yashmangrole/Kruger-Robot/images/Krugger.png

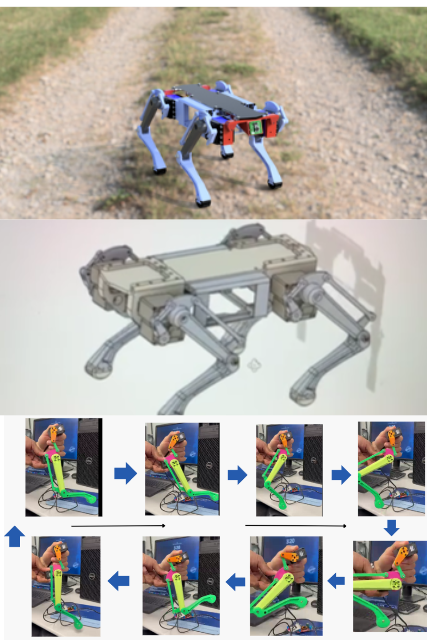
images/Krugger.png
