yashmangrole/Kruger-Robot/images/Kruger1.png

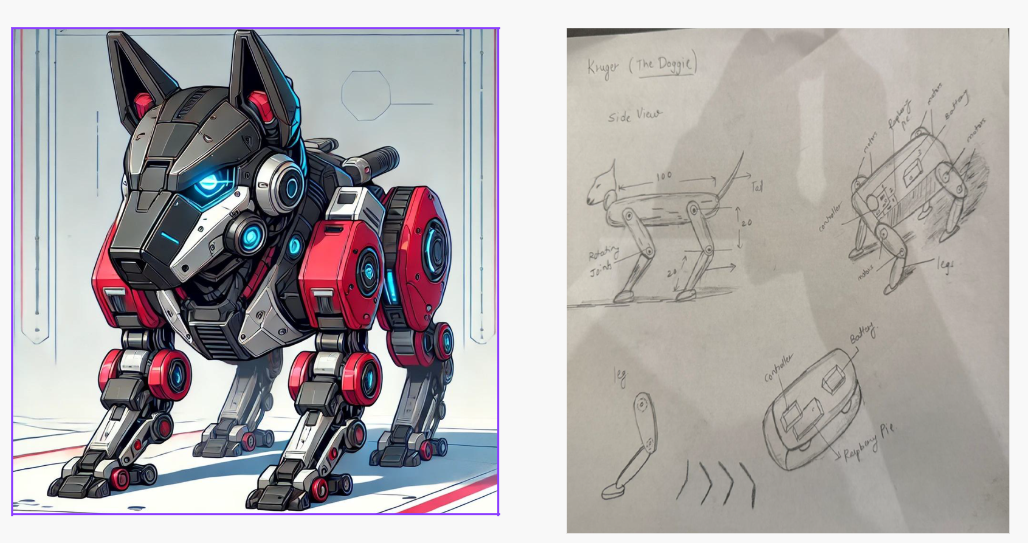
images/Kruger1.png
