yashmangrole/Kruger-Robot/docs/Assignment4_LegMotion.pdf

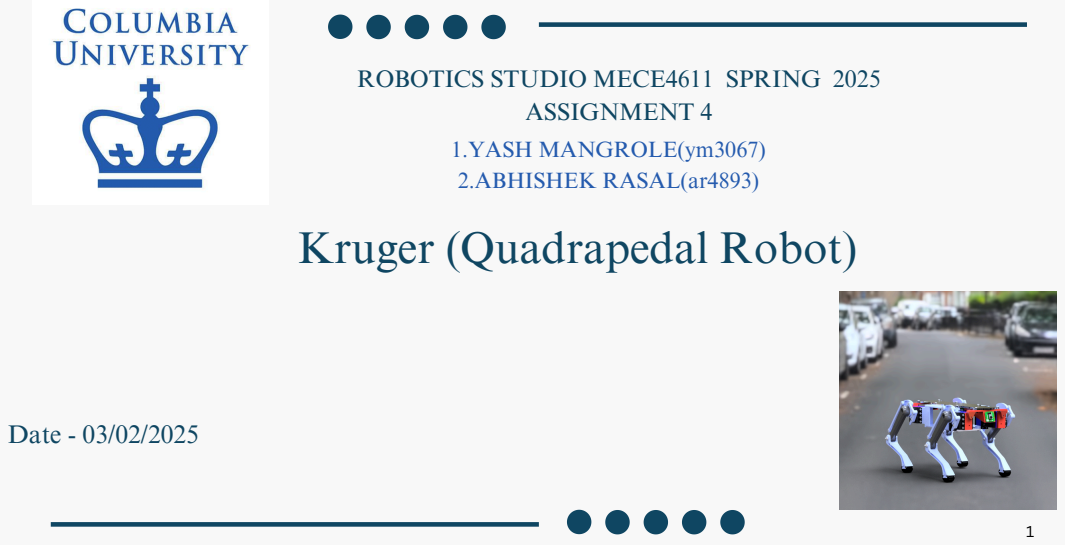
[picture p3: page 1]
ASSIGNMENT 4; 1.YASH MANGROLE(ym3067) 2.ABHISHEK RASAL(ar4893); Date - 03/02/2025

ROBOTICS STUDIO MECE4611 SPRING 2025

Kruger (Quadrapedal Robot)

# Leg Motion of Kruger

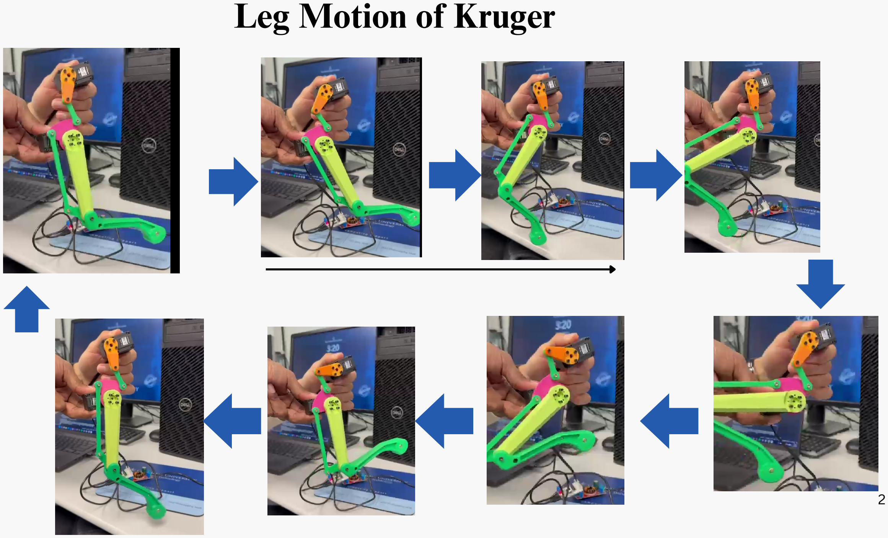
[picture p4: page 2]

2

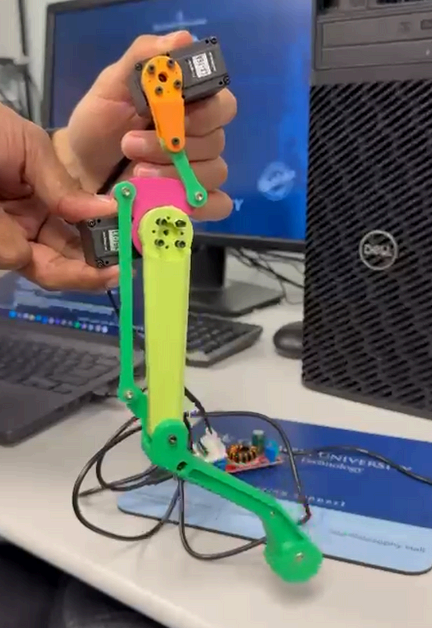
[picture p5: figure]
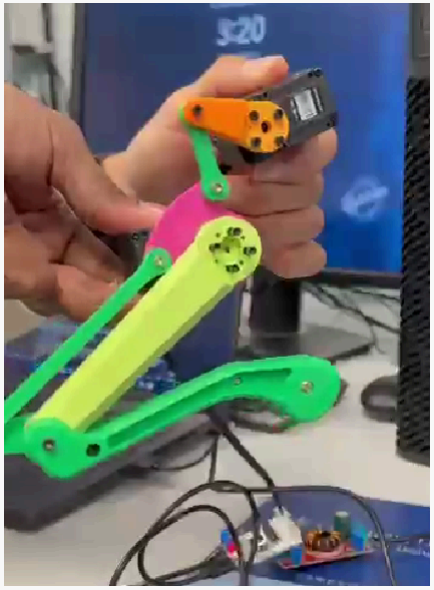
[picture p6: figure]

3

# Leg Motion of Kruger Video

# https://drive.google.com/file/d/1w5T3N-5B1o2JqB9dnsWIKcZQCd3il7GZ/view?

usp=drive_link (https://drive.google.com/file/d/1w5T3N-5B1o2JqB9dnsWIKcZQCd3il7GZ/view?usp=drive_link)

# Extreme Leg Position of Kruger

# Code for Execution

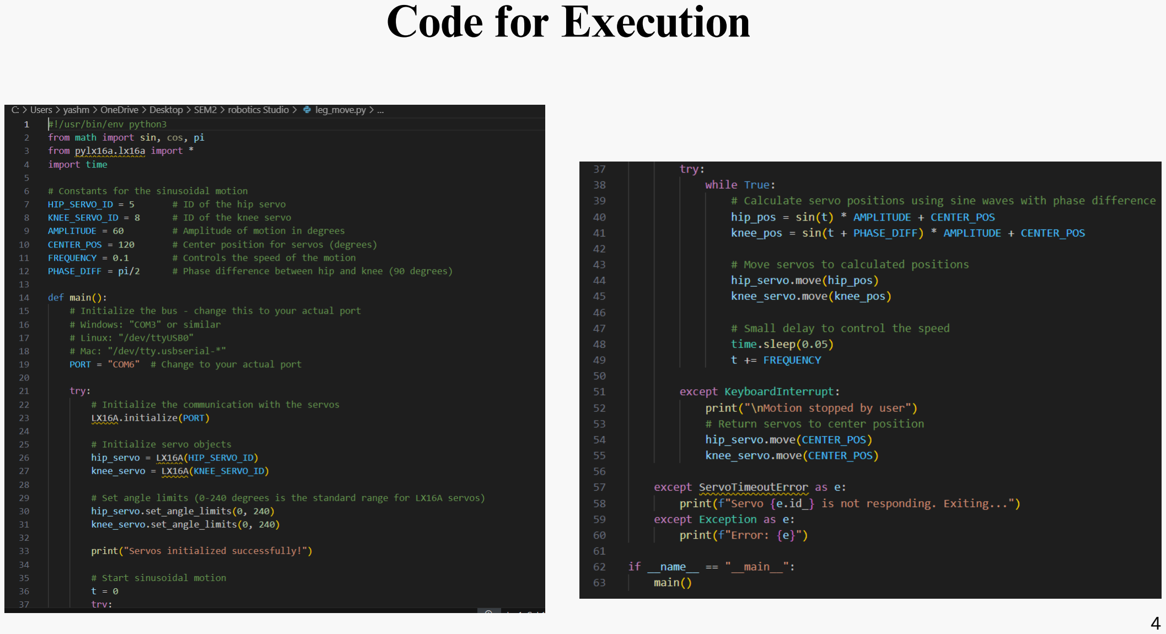
[picture p7: page 4]

4

# Cable Routing

# 3D-print quality, support

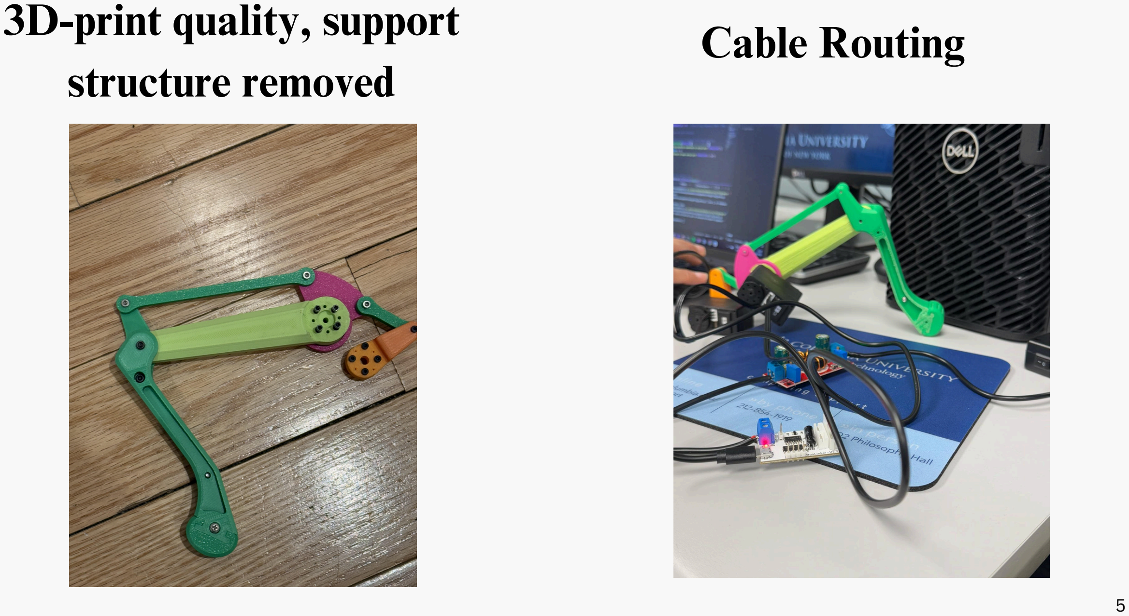
[picture p8: page 5]

5

# structure removed

# Nuts and Bolts Integration to Kruger

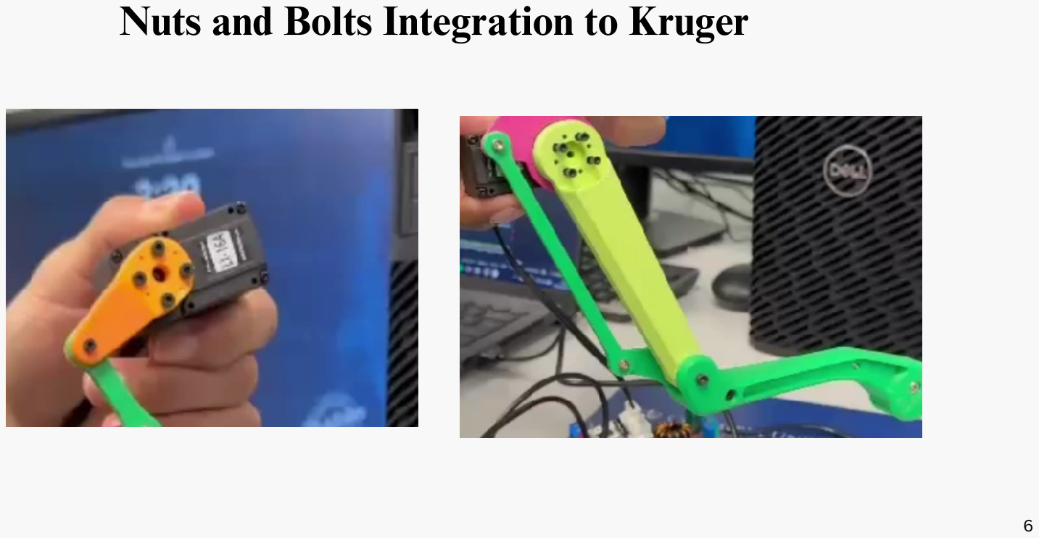
[picture p9: page 6]

6

7

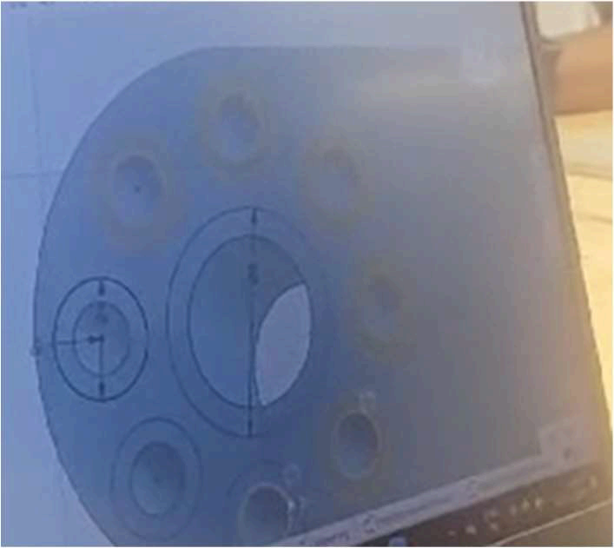
[picture p10: figure]

## 1. Servo motors Shaft was 4 x mm in depth. However, in Grabcad, the

models were 3.45mm in depth.

## 2. The screw holes are smaller when 3d printed so we need to increase the size 3. Leg to servo attachments are too thin, we need to thicken them and apply a counter bore

# Form and Fit Issues identified

# Posted On Ed

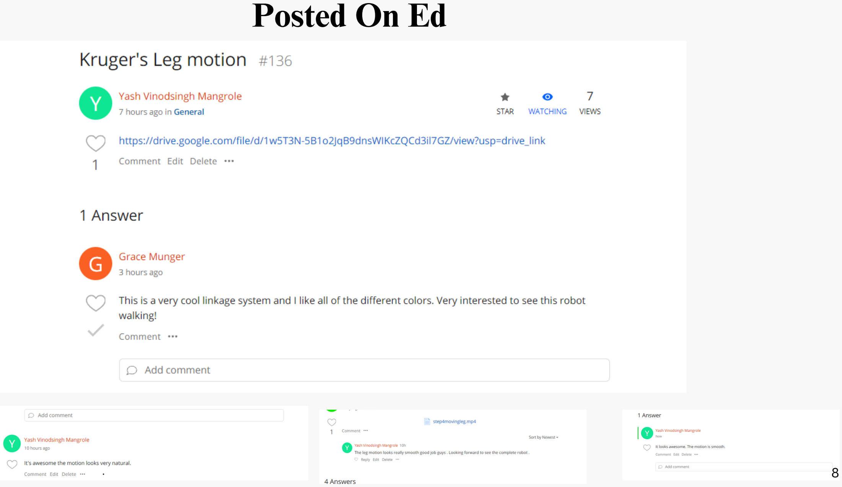
[picture p11: page 8]

8

9

Title slide complete
overall aesthetics, layout and formatting of the slides
Sequence of photos showing leg in motion
posting video of moving leg on the discussion board at least 24h in advance of deadline, and commenting constructively and positively on at least three other’s postings (show screenshots)
extreme leg positions tested and measured
form/fit issues identified, listed and addressed (show how)
all components properly bolted and connected (with inserts)
3D-print quality, support structure removed
Different leg motion patterns explored
Leg Modularity demonstrated
Cables routed properly and securely
Exception handling in code catches motor disconnect

# Rubrics Attempted

10

# Thank You
