yashmangrole/Kruger-Robot/images/finalcad1.png

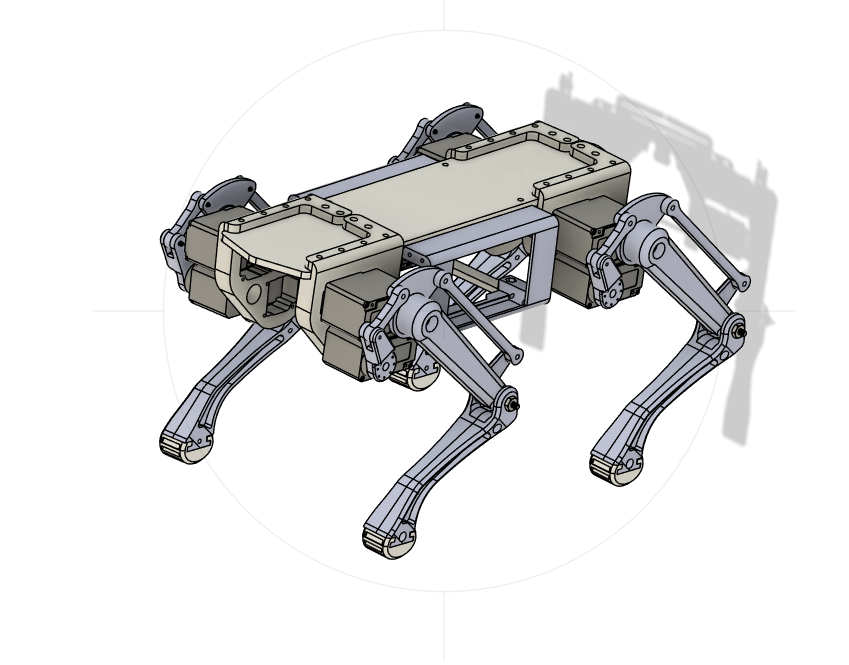
images/finalcad1.png
