yashmangrole/Kruger-Robot/images/finalcad2.png

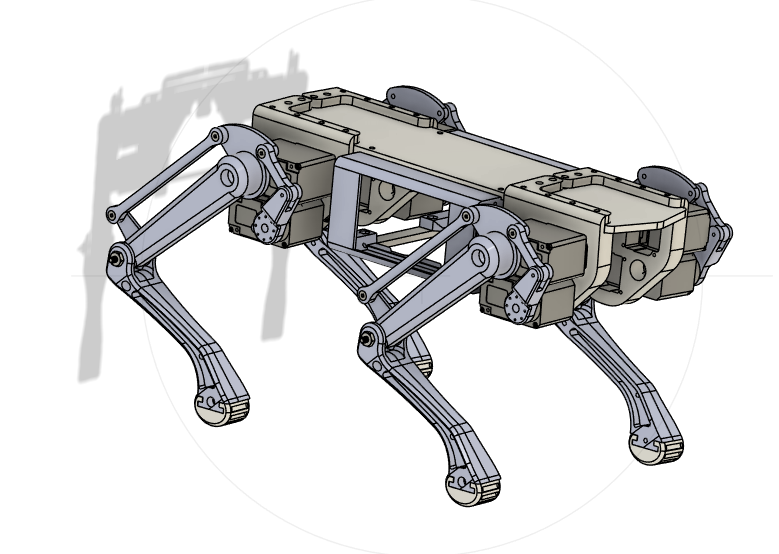
images/finalcad2.png
