yashmangrole/Kruger-Robot/cad/DESIGN_1 v33.step

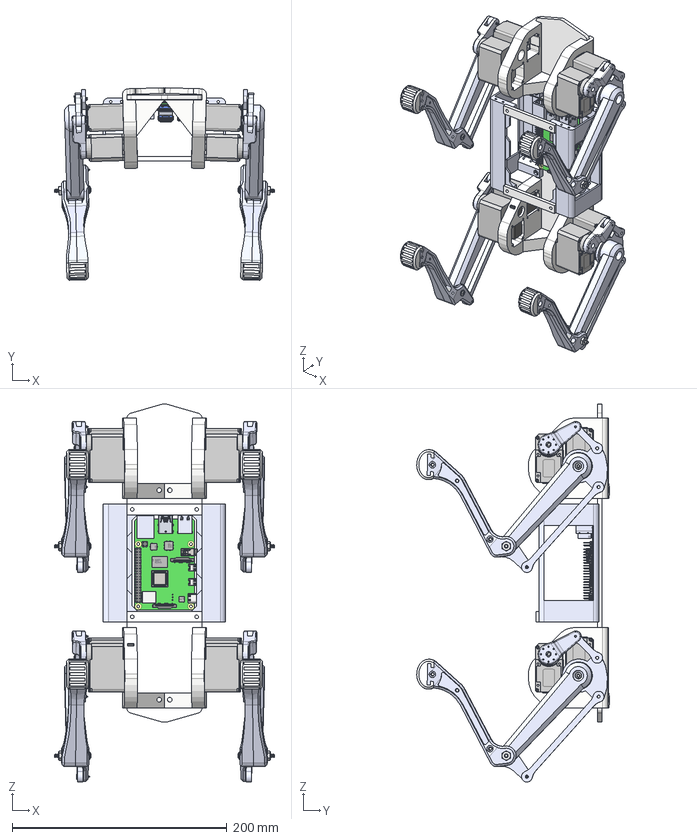
[picture p14: CAD file, 2026-10-29]
cad/DESIGN_1 v33.step
205.0 x 179.2 x 351.8 mm
side_body x 2
wood_board
servo_holder_rear_fixed x 2
screw_m3_12mm_90116A157 x 16
femur_1 x 2
foot_1 x 2
link_100mm_1 x 2
link_28mm_1 x 2
motor_connect_1_1 x 4
motor_extension_taller_1 x 2
shoulder_disk_left_1 x 2
tibia_left_inner_1 x 2
tibia_left_outer_1 x 2
screw_6-32x1.25inch_91772A155_1 x 2
nut_6-32_90480A007_1 x 2
screw_m3_15mm_92095A119_1 x 2
screw_4_0.5inch_90610A110_1 x 41
screw_m3_4mm_92000A113_1 x 2
PCB, RPi4ModelB
Broadcom BCM2711B0 CPU, RPi4ModelB
2.54 mm DUPONT MALE PIN HEADER, POE, 2X2, RPi4ModelB
2.54 mm DUPONT MALE PIN HEADER, IO, 2X20, RPi4ModelB
Camera Connector, RPi4ModelB
Microphone Plug, RPi4ModelB
Display Connector, RPi4ModelB
Gigabit Ethernet Port, RPi4ModelB
Female Micro HDMI Connector, RPi4ModelB x 2
Female USB Type C Connector, RPi4ModelB
2X USB3.0 PORTS, RPi4ModelB
91D77 D9WHV 778K, 4 GB LPDDR4 SDRAM, RPi4ModelB
Cypress CYW43455 Wireless Module Cover, RPi4ModelB
SD Card Slot, RPi4ModelB
VIA VL805 PCIe USB 3.0 controller, RPi4ModelB
2X USB2.0 PORTS, RPi4ModelB
Broadcom BCM54213PE Gigabit Ethernet Transceiver, RPi4ModelB
MxL7704 Universal PMIC, RPi4ModelB
rocker_switch
servo_holder_right_inner
servo_holder_outer x 3
body_end_switch
link_belly x 2
Lewansoul LX-16A Servo x 3
Motor Adapter (LX-16A) x 3
Lewansoul LX-16A Servo_1 x 5
Motor Adapter (LX-16A)_1 x 5
femur
foot
link_100mm
link_28mm
motor_connect_1
motor_extension_taller
shoulder_disk_left
tibia_left_inner
tibia_left_outer
screw_6-32x1.25inch_91772A155
nut_6-32_90480A007
screw_m3_15mm_92095A119
screw_4_0.5inch_90610A110 x 4
screw_m3_4mm_92000A113
Lewansoul LX-16A Servo_3 x 3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
