yashmangrole/Kruger-Robot/cad/legs/Leg 1/femur.step

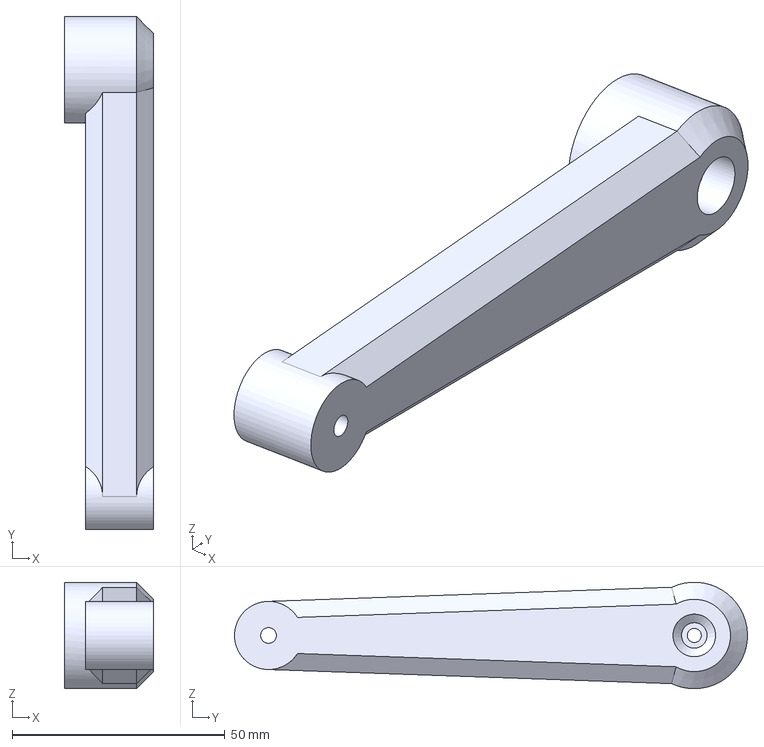
[picture p15: CAD file, 2026-10-29]
cad/legs/Leg 1/femur.step
21.0 x 120.5 x 25.0 mm
