yashmangrole/Kruger-Robot/cad/legs/Leg 1/Leg 2/tibia_right_outer.step

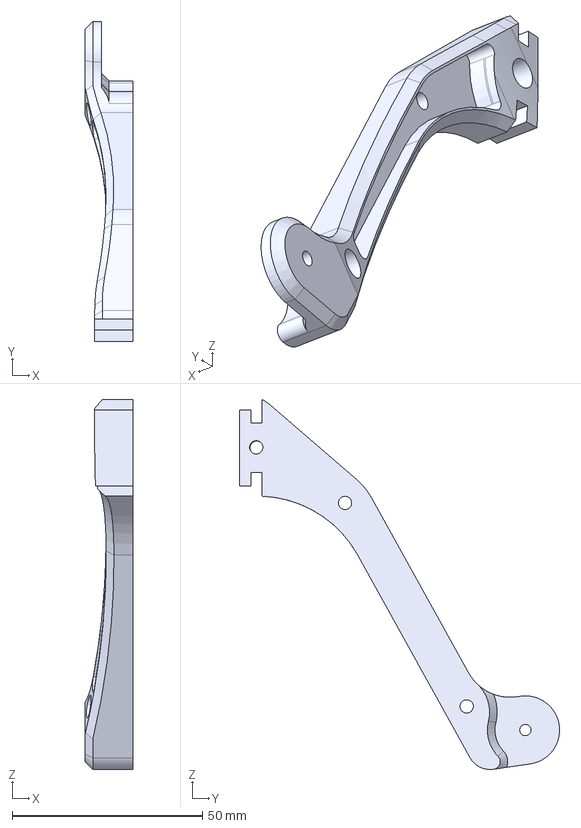
[picture p16: CAD file, 2026-10-29]
cad/legs/Leg 1/Leg 2/tibia_right_outer.step
12.5 x 84.2 x 97.4 mm
