yashmangrole/Kruger-Robot/cad/legs/Leg 3/link_28mm(Mirror) (1).step

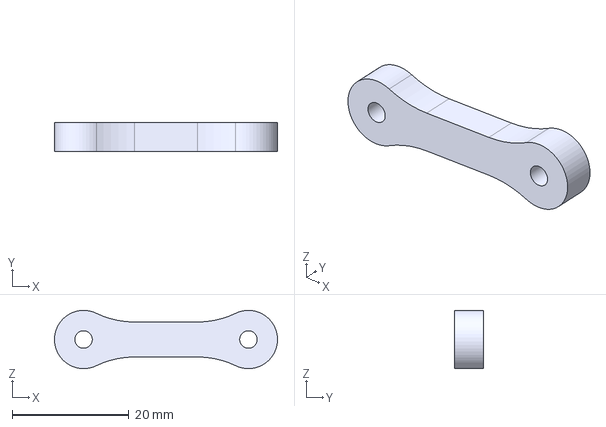
[picture p17: CAD file, 2026-10-29]
cad/legs/Leg 3/link_28mm(Mirror) (1).step
38.3 x 5.00 x 9.99 mm
