yashmangrole/Kruger-Robot/cad/legs/Leg4/foot.step

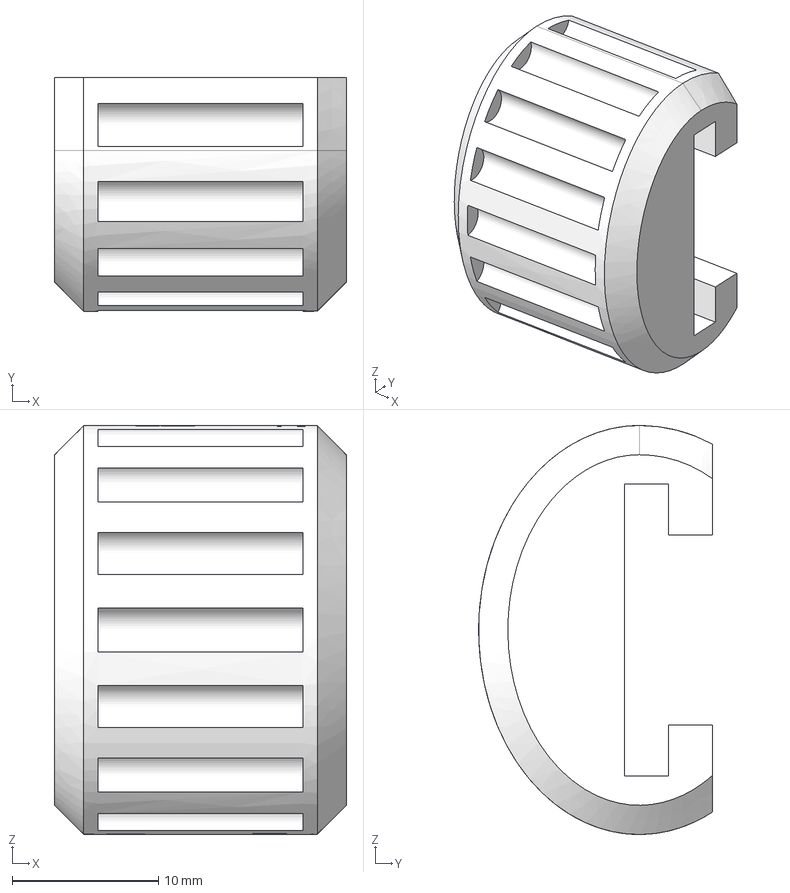
[picture p18: CAD file, 2026-10-29]
cad/legs/Leg4/foot.step
20.0 x 16.0 x 28.0 mm
