yashmangrole/Kruger-Robot/cad/legs/Leg 3/motor_connect_1(Mirror) (1).step

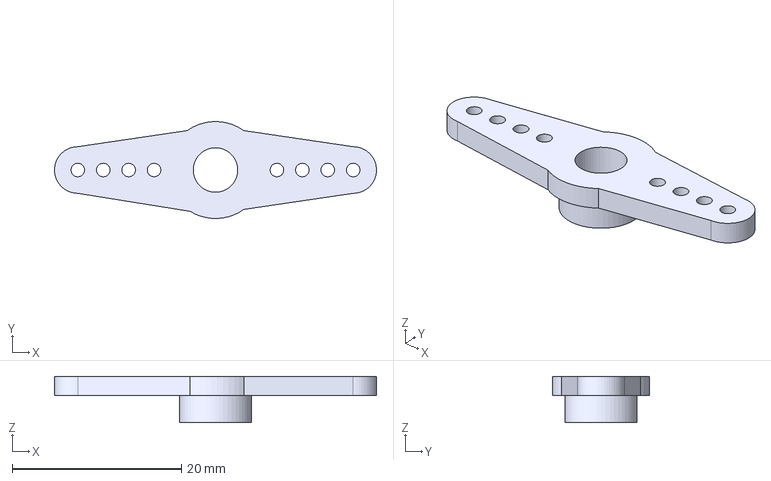
[picture p19: CAD file, 2026-10-29]
cad/legs/Leg 3/motor_connect_1(Mirror) (1).step
38.0 x 11.4 x 5.48 mm
