yashmangrole/Kruger-Robot/cad/Servo sideways mount v4.step

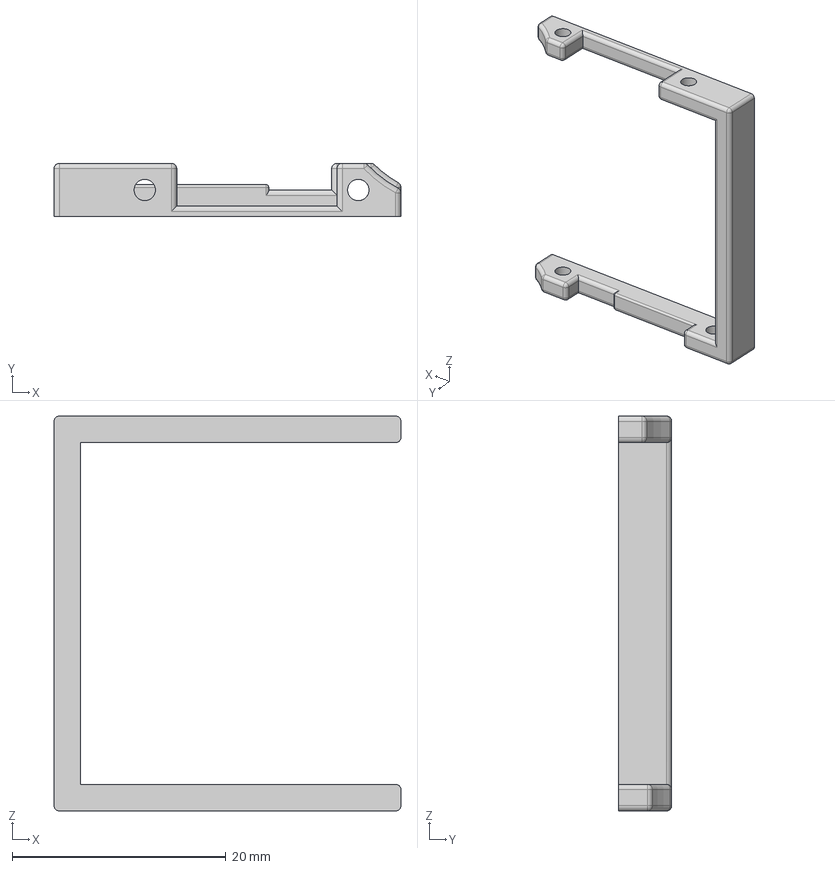
[picture p20: CAD file, 2026-10-29]
cad/Servo sideways mount v4.step
32.5 x 5.00 x 37.0 mm
