yashmangrole/Kruger-Robot/cad/legs/Leg 1/Leg 2/tibia_right_inner.step

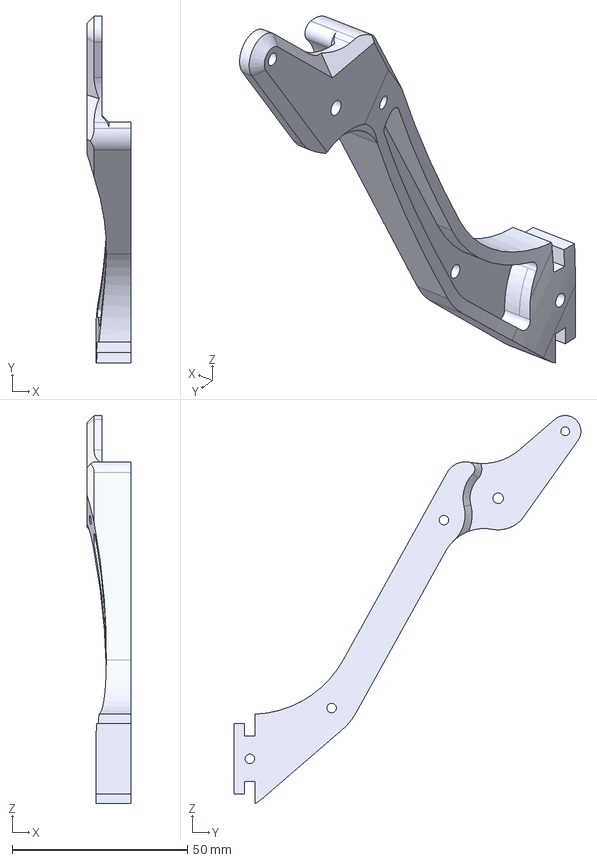
[picture p21: CAD file, 2026-10-29]
cad/legs/Leg 1/Leg 2/tibia_right_inner.step
12.5 x 98.8 x 110.6 mm
