yashmangrole/Kruger-Robot/cad/legs/Leg 1/link_100mm.step

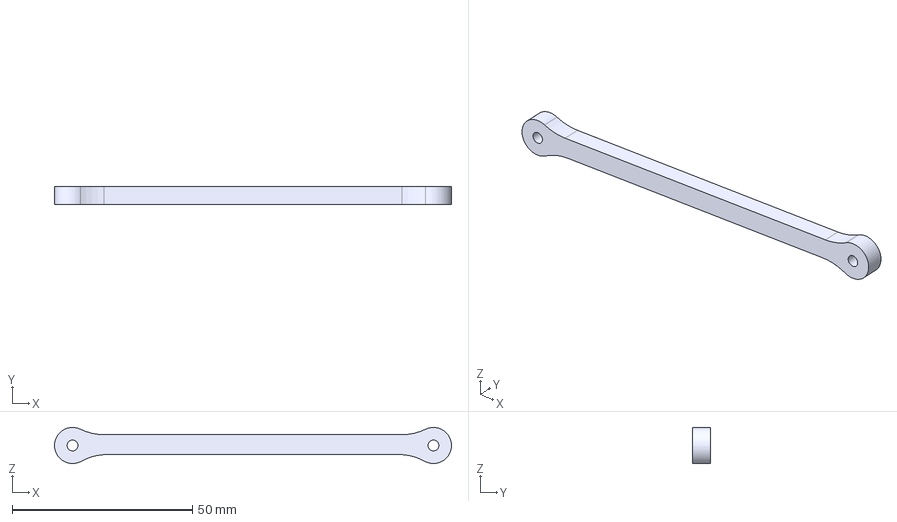
[picture p22: CAD file, 2026-10-29]
cad/legs/Leg 1/link_100mm.step
110.0 x 5.00 x 9.99 mm
