yashmangrole/Kruger-Robot/cad/legs/Leg 3/shoulder_disk_left(Mirror) (1).step

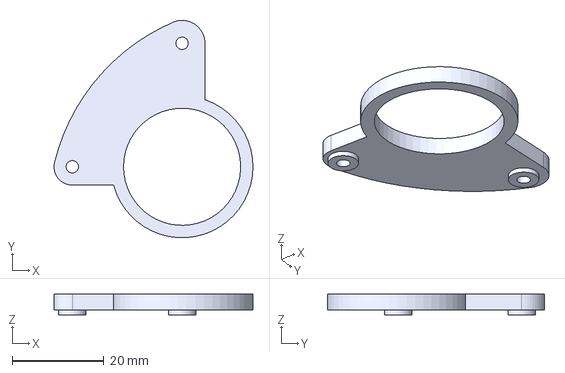
[picture p23: CAD file, 2026-10-29]
cad/legs/Leg 3/shoulder_disk_left(Mirror) (1).step
43.5 x 47.5 x 4.50 mm
