yashmangrole/Kruger-Robot/cad/legs/Leg 1/Leg 2/shoulder_disk_right.step

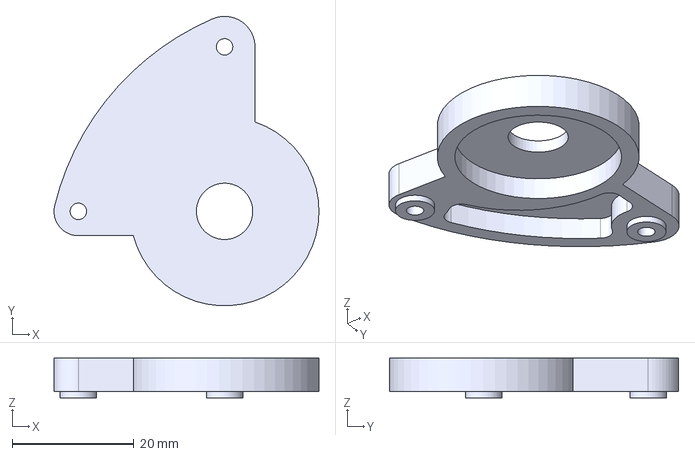
[picture p24: CAD file, 2026-10-29]
cad/legs/Leg 1/Leg 2/shoulder_disk_right.step
43.5 x 47.5 x 6.50 mm
