yashmangrole/Kruger-Robot/cad/legs/Leg 1/motor_extension_taller.step

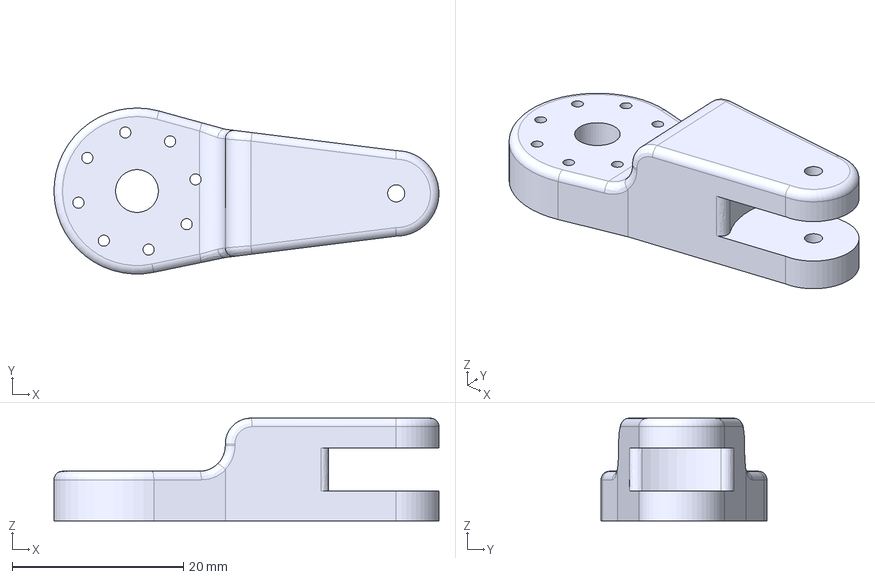
[picture p25: CAD file, 2026-10-29]
cad/legs/Leg 1/motor_extension_taller.step
45.0 x 19.4 x 12.0 mm
