yashmangrole/Kruger-Robot/(list of files, cad)

Other CAD files:
cad/legs/Leg 1/Leg 2/foot.step
cad/legs/Leg 1/link_28mm.step
cad/legs/Leg4/motor_connect_1.step
cad/legs/Leg4/shoulder_disk_left.step
cad/legs/Leg 1/tibia_left_inner.step
cad/legs/Leg 3/link_100mm(Mirror) (1).step
cad/legs/Leg4/tibia_left_inner.step
cad/legs/Leg 1/Leg 2/motor_connect_1.step
cad/legs/Leg 3/tibia_left_inner(Mirror) (1).step
cad/legs/Leg4/motor_extension_taller.step
cad/legs/Leg 1/Leg 2/link_100mm.step
cad/legs/Leg 1/shoulder_disk_left.step
cad/legs/Leg 3/tibia_left_outer(Mirror) (1).step
cad/legs/Leg4/link_28mm.step
cad/legs/Leg 1/Leg 2/motor_extension_taller.step
cad/legs/Leg 1/tibia_left_outer.step
cad/legs/Leg 3/femur(Mirror) (1).step
cad/legs/Leg4/tibia_left_outer.step
cad/legs/Leg 1/Leg 2/link_28mm.step
cad/legs/Leg 1/servo_spt5435LV.step
cad/legs/Leg 3/motor_extension_taller(Mirror) (1).step
cad/legs/Leg4/femur.step
cad/legs/Leg 1/Leg 2/femur.step
cad/legs/Leg 1/motor_connect_1.step
cad/legs/Leg 3/foot(Mirror) (1).step
cad/legs/Leg4/link_100mm.step
